ojasm07/Design-Control-and-Fabrication-of-Ornithopter/Major Project Review Presentation.pptx.pdf

30-June-22 | Department of Mechanical Engineering

# Design, Fabrication and Control of an Ornithopter

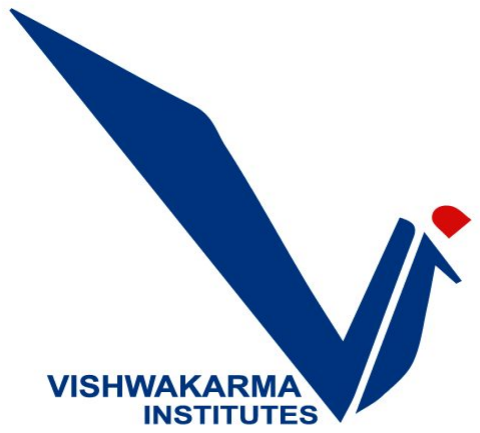
[picture p1: figure]

### Under the Guidance of : Prof. (Dr.) S. Pavitran

# Major Project

1

### Department of Mechanical Engineering

ME 4356

02-Jan-21 30-June-22 | Department of Mechanical Engineering | 2

## Group Members

Prof. (Dr.) Sunil Shinde, VIT-Mech, Pune, INDIA

Division & Roll No. | Name | Gr. No.
A-19 | Dhiren Bhabad | 11810572
C-22 | Ojas Mandlecha | 11810880
B-08 | Sankalp Gharmalkar | 11810519
A-68 | Shreeya Gadgil | 11810511

### Final Year Mechanical

30-June-22 | Department of Mechanical Engineering | 2

## Objectives

1. To build an efficient mechanism that can perform motion similar to the motion of wings of bird.
2. To design a mechanism for the tail of the ornithopter to control direction during flight.
3. Designing wings of the ornithopter considering the lift force required.
4. To design the robot in Solidworks software with consideration of assembly and manufacturing.
5. To build two testing setups to measure the thrust provided and to check the flight stability of the

ornithopter.

- Biomimetics or biomimicry is the emulation of the models, systems, and elements of nature for the purpose of solving complex human problems.
- In simple words “Biomimicry is the practice of looking to nature for inspiration to solve design problems in a regenerative way.”
- To replicate the wing flapping mechanism of Buzzard.
- The ornithopter could be used for surveillance, traffic monitoring or wildlife surveys.

## Introduction

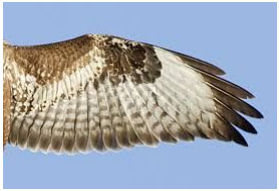
[picture p2: figure]

Fig.1. Wing of Buzzard

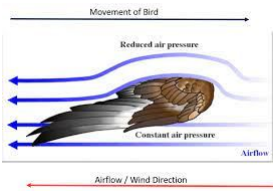
[picture p3: figure]
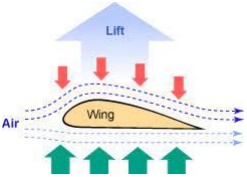
[picture p4: figure]

Fig.2. Flow of air over shape of wing

## Literature Review

Sr. No. | Title and Author | Objective | Methodology | Result and Conclusion
1. Design and Implementation of
an Ornithopter

Dan Sanderson, Jourdan
McKenna, Brian Baggaley,
Frederic Wight
1. The primary objective
is to make a
mechanical design.
2. Be able to transition
from flapping to
gliding and back to
flapping with minimal
disruption of flight
pattern.
1. The model was based on the Robin bird. Accordingly,
specifications were
calculated.
2. Different types of wing designs were tried and
tested.
3. Variation in flapping was tested on a setup with the ornithopter attached to a
zipline.
4. A Vernier Force Sensor was used to measure the force
during flapping.
1. The robot was able to transition from flipping to gliding with minimal flight pattern disruption.
2. Robot can achieve a velocity of 0.848 m/s on the zip line.
3. It was durable enough to withstand impacts while testing.

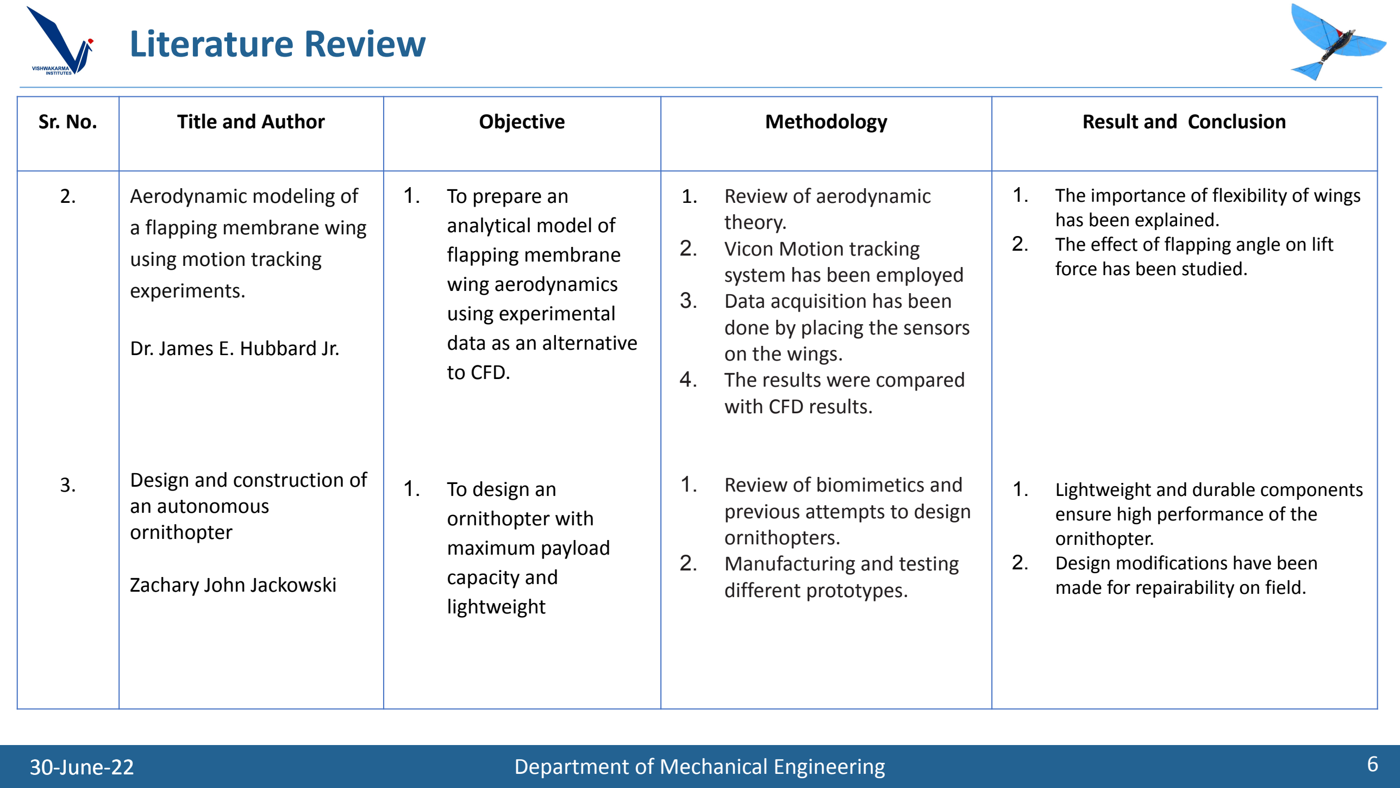
[picture p5: figure]
Literature Review; Aerodynamic modeling of; a flapping membrane wing; using motion tracking; experiments.; Dr. James E. Hubbard Jr.; Design and construction of an autonomous ornithopter; Zachary John Jackowski; 1. To prepare an analytical model of flapping membrane wing aerodynamics using experimental data as an alternative to CFD.; 1. To design an ornithopter with maximum payload capacity and lightweight; 1. Review of aerodynamic theory. 2. Vicon Motion tracking system has been employed 3. Data acquisition has been done by placing the sensors on the wings. 4. The results were compared with CFD results.; 1. Review of biomimetics and previous attempts to design ornithopters. 2. Manufacturing and testing different prototypes.; has been explained. 2. The effect of flapping angle on lift force has been studied.; 1. Lightweight and durable components ensure high performance of the ornithopter. 2. Design modifications have been made for repairability on field.

Sr. No. | Title and Author | Objective | Methodology | Result and Conclusion
1. The importance of flexibility of wings

## Methodology

Mechanism And
Calculation

Finding
mechanism for
respective task and
performing its
corresponding
calculations.

Design

CAD modeling of
the robot based on
the calculations.

Testing

Measurement of
acquired lift force
and flight stability
of prototypes.

Final Results and
Manufacturing

Finalizing the
Model.

Optimization

Optimization or
modification in
design according to
the results obtained
from testing.

## Determining the wing area

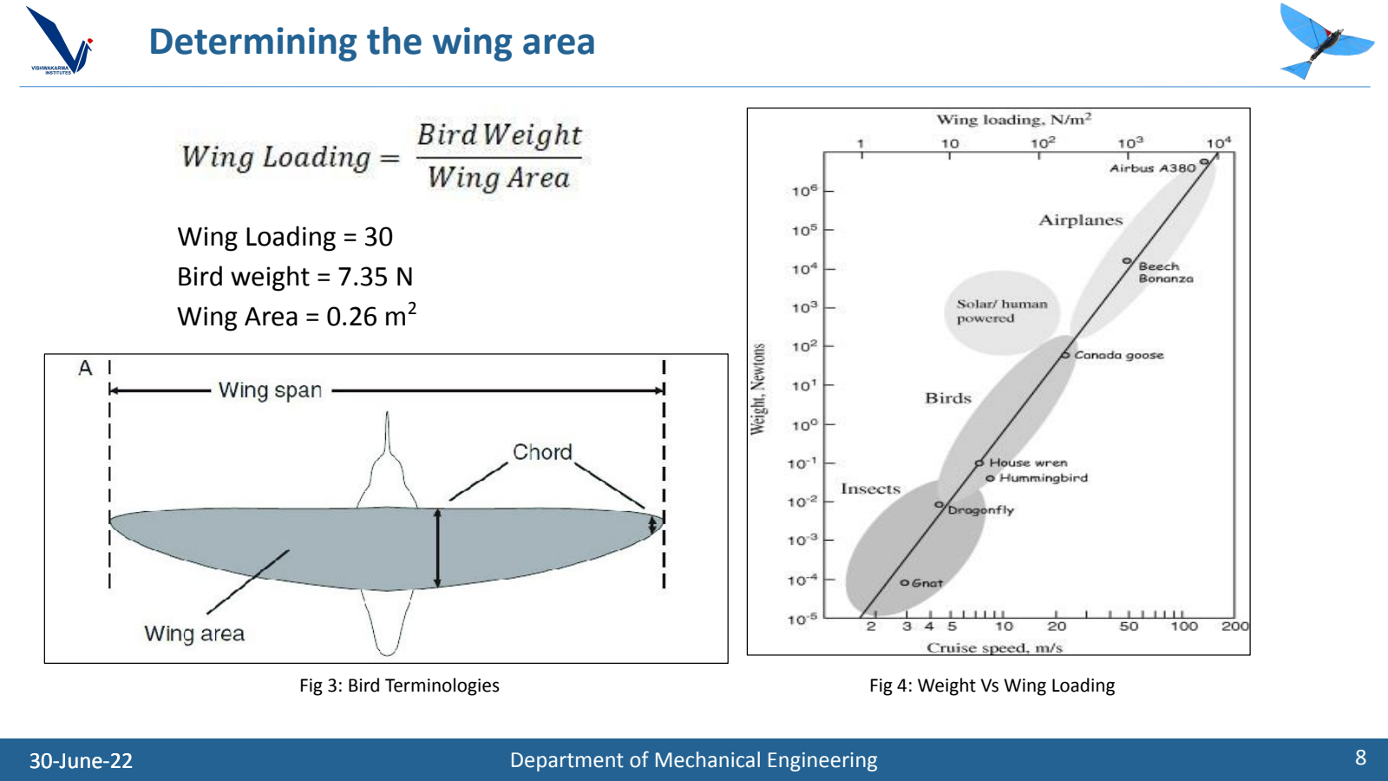
[picture p6: page 8]

Wing Loading = 30
Bird weight = 7.35 N
Wing Area = 0.26 m²
Fig 3: Bird Terminologies | Fig 4: Weight Vs Wing Loading

## Weight of Components

Department of Mechanical Engineering

Components | Weight (grams) | Quantities | Total Weight (grams)
Main Body | 75 | 1 | 75
Gear Box | 165 | - | 165
BLDC Motor | 80 | 1 | 80
Servo Motor | 45 | 1 | 45
Shaft & Bearings | 20 | 3 | 60
Electronics | 100 | - | 100
Battery | 85 | 1 | 85
Wings | 40 | 2 | 80
Total Weight | | | 690

Table No. 1 Weight Estimation

### - Down stroke - Lift force - Partial Thrust

### - Up stroke - Partial Thrust

## Wing Flexibility

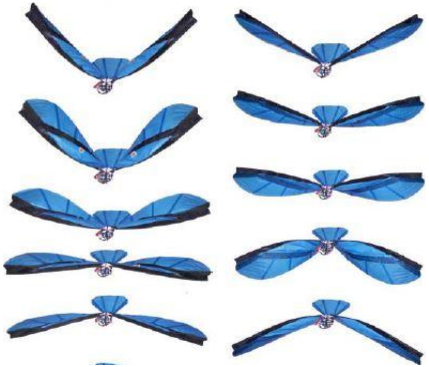
[picture p7: figure]

Fig 5: Wing positions of Ornithopter

## BLDC Motor Torque Calculations

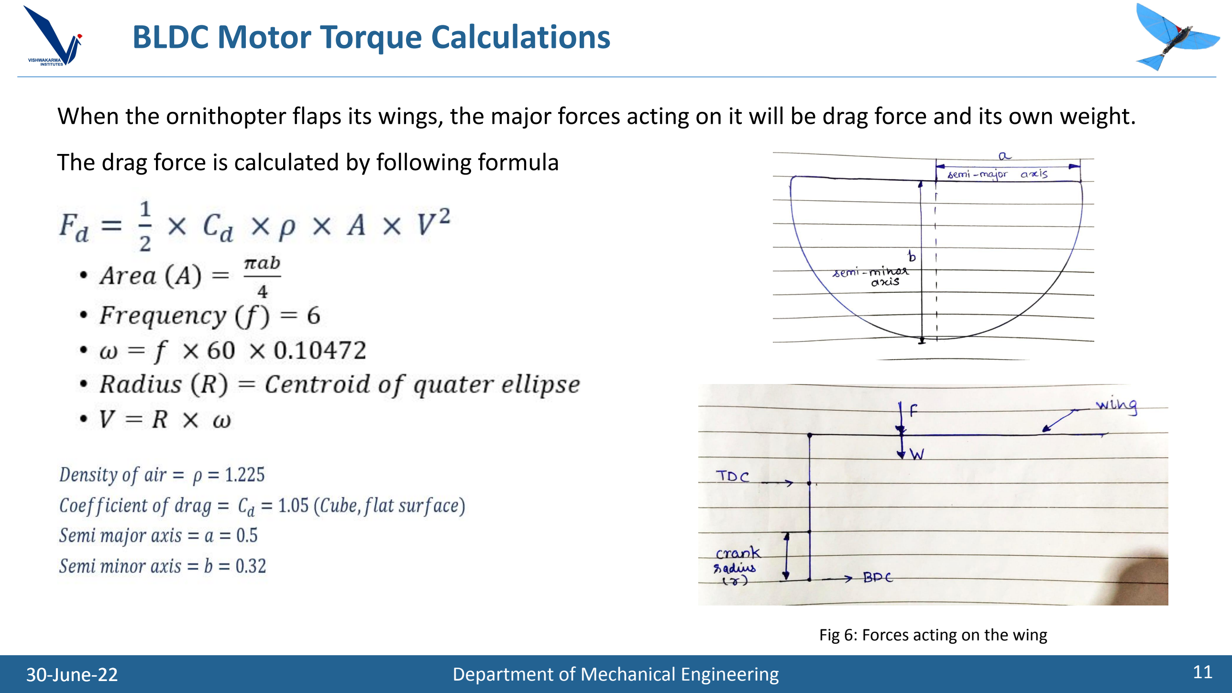
[picture p8: page 11]

When the ornithopter flaps its wings, the major forces acting on it will be drag force and its own weight.

The drag force is calculated by following formula

Fig 6: Forces acting on the wing

## BLDC Motor Torque Calculations

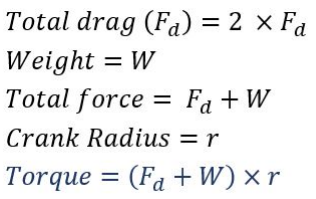
[picture p9: figure]

All these values and formulas were calculated in excel sheet to narrow down the the reduction ratio and

BLDC motor.

https://docs.google.com/spreadsheets/d/1AwN7oHJm2QgTFMpb154mPdjUXOrblMUWJqgVfvwyTiw/edit#

gid=0 (https://docs.google.com/spreadsheets/d/1AwN7oHJm2QgTFMpb154mPdjUXOrblMUWJqgVfvwyTiw/edit#gid=0)

## CAD model

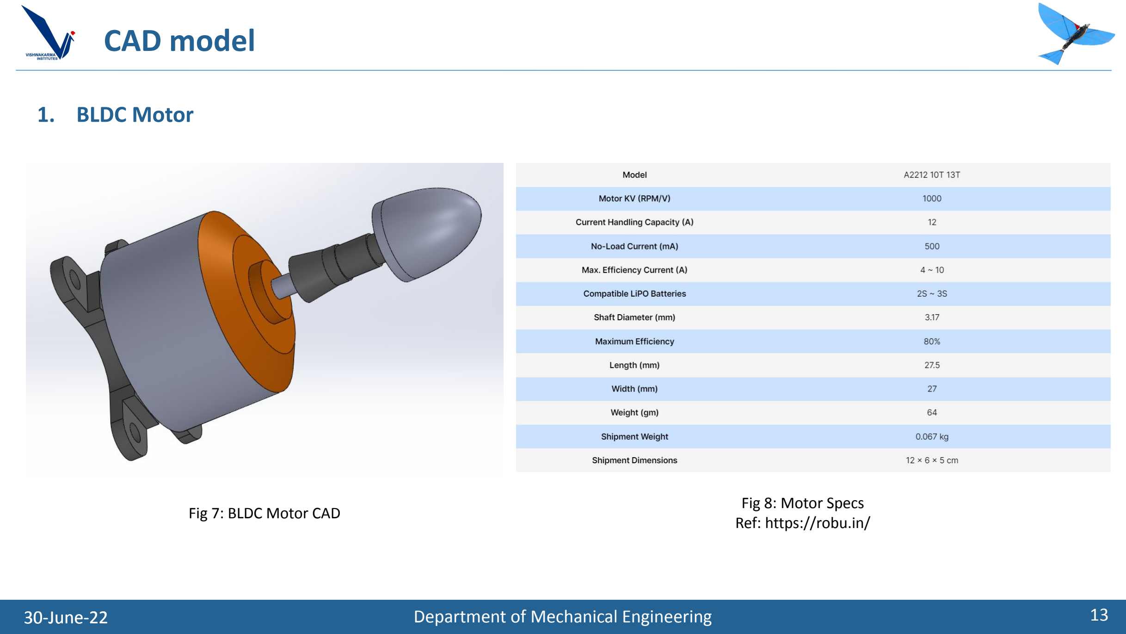
[picture p10: page 13]

Fig 8: Motor Specs
Ref: https://robu.in/ Fig 7: BLDC Motor CAD

### 1. BLDC Motor

## CAD model

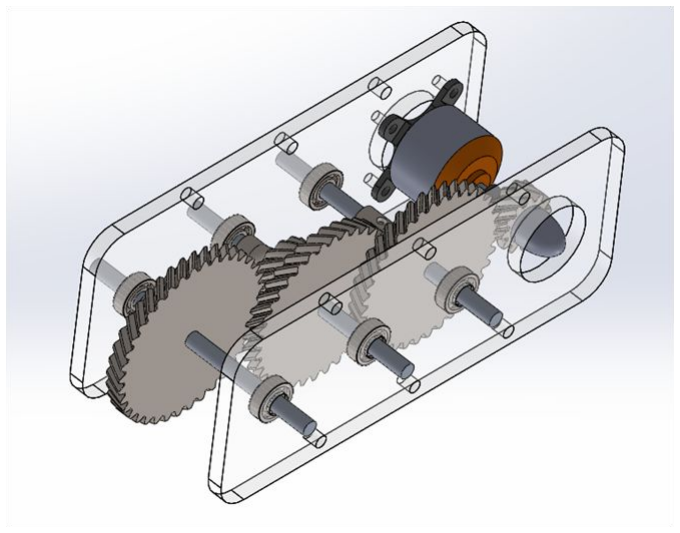
[picture p11: figure]

Fig 9: Gearbox with BLDC Motor

### 2. Gearbox

## Calculations

Gearbox Reduction Calculation

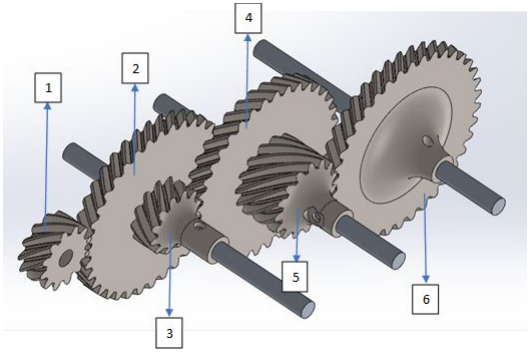
[picture p12: figure]

Gear No. | No. of teeth | Total Reduction achieved
1 (Input Gear) | 12 | 0
2 | 36 | 36/12=3
3 | 12 | 3 (Compound Gear)
4 | 36 | 3 x (36/12) = 9
5 | 15 | 9 (Compound Gear)
6 (Output Gear) | 38 | 9 x (38/15) = 22.8
Fig 10: Gearbox | | Table No. 2 Gear reduction values

Type of Gear Train: Compound Gear Train Type of gears used: Helical Gear

## CAD model

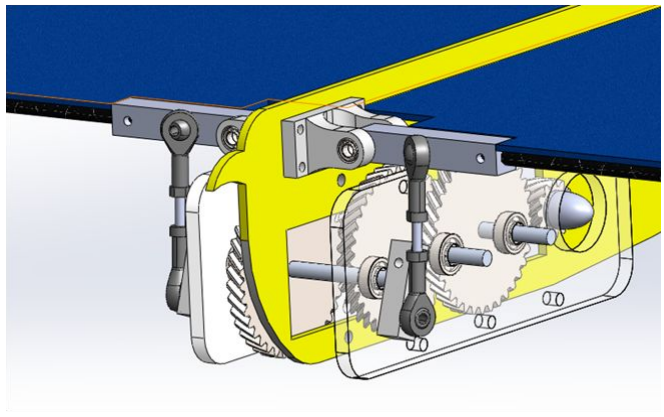
[picture p13: figure]

Fig 11: Wing Front Pivot

### 3. Ornithopter Wing Front Pivot Mechanism

- Assumption: We have assumed here, that when the crank is at the bottom dead center (lowest position) the wing would he horizontal.
- Considering this, geometrical relationship between the flapping angle of wing, crank radius, center distance between rod end bearings and distance between rod end bearing and frontal pivot was established.

AP = Center distance between rod end bearings (d)
BP = Crank Diameter (2r)
OA = Distance between rod end bearing and frontal pivot (x) ∠NOM = Flapping angle of wing (θ)

## Front pivot mechanism calculations

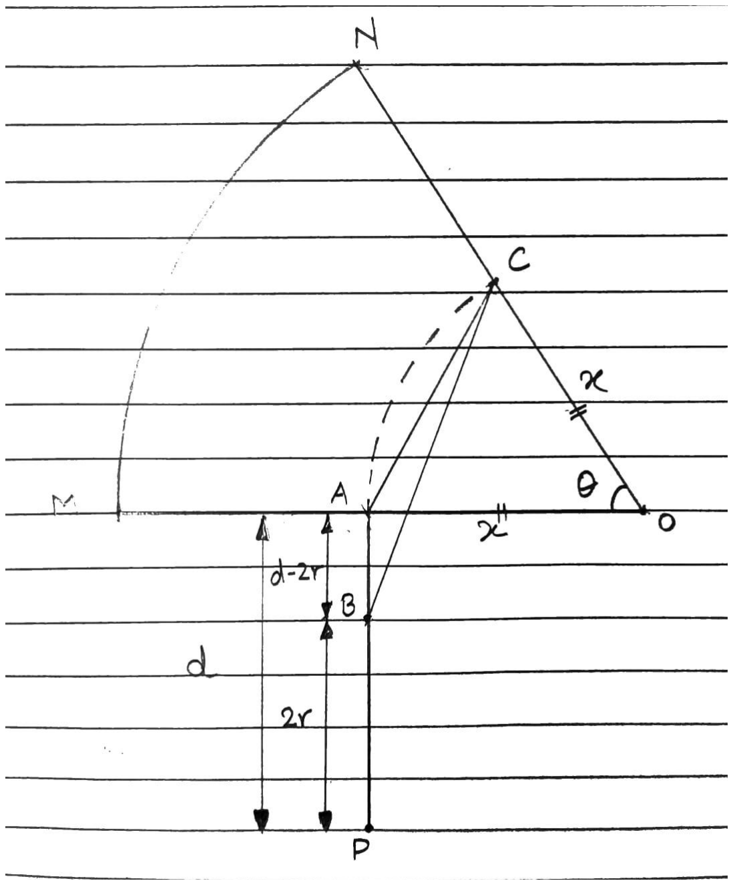
[picture p14: figure]

Fig.12: 2D representation of front pivot mechanism (front view)

## Front pivot mechanism calculations

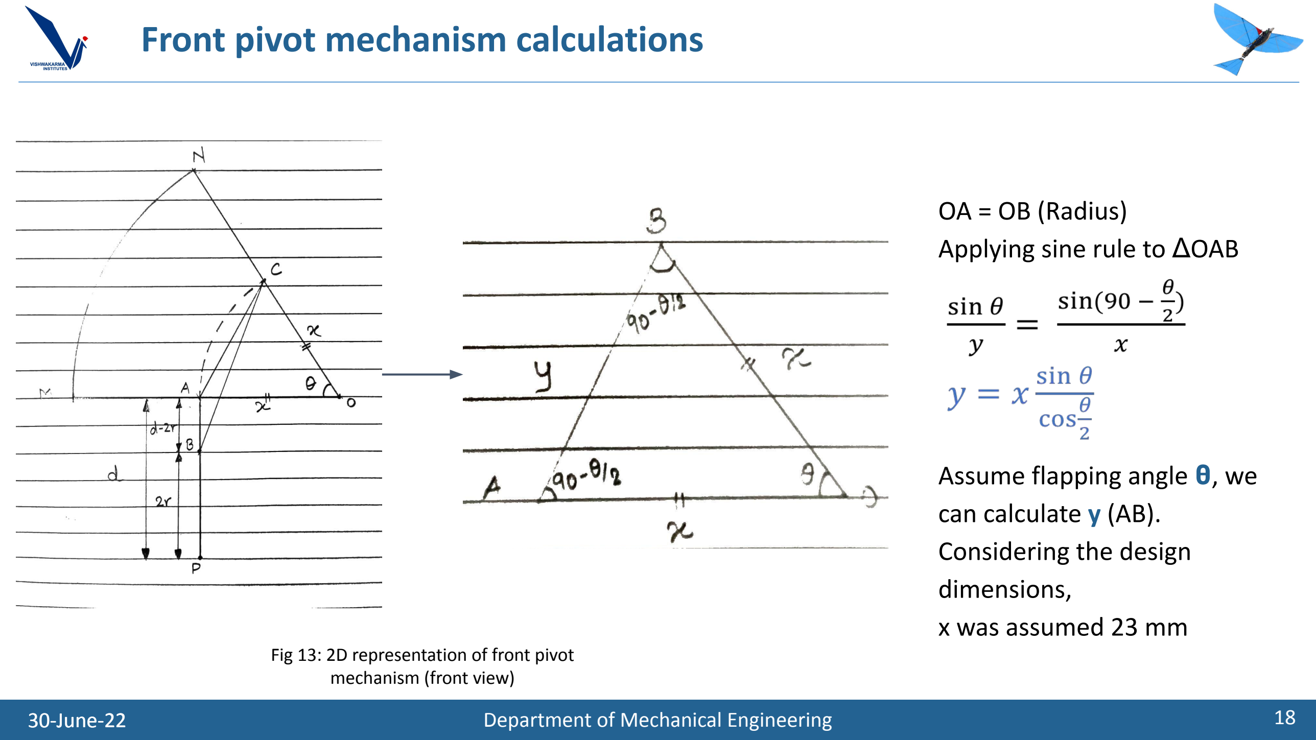
[picture p15: page 18]

OA = OB (Radius)
Applying sine rule to ΔOAB

Assume flapping angle ፀ, we can calculate y (AB).
Considering the design
dimensions,
x was assumed 23 mm

Fig 13: 2D representation of front pivot mechanism (front view)

## Front pivot mechanism calculations

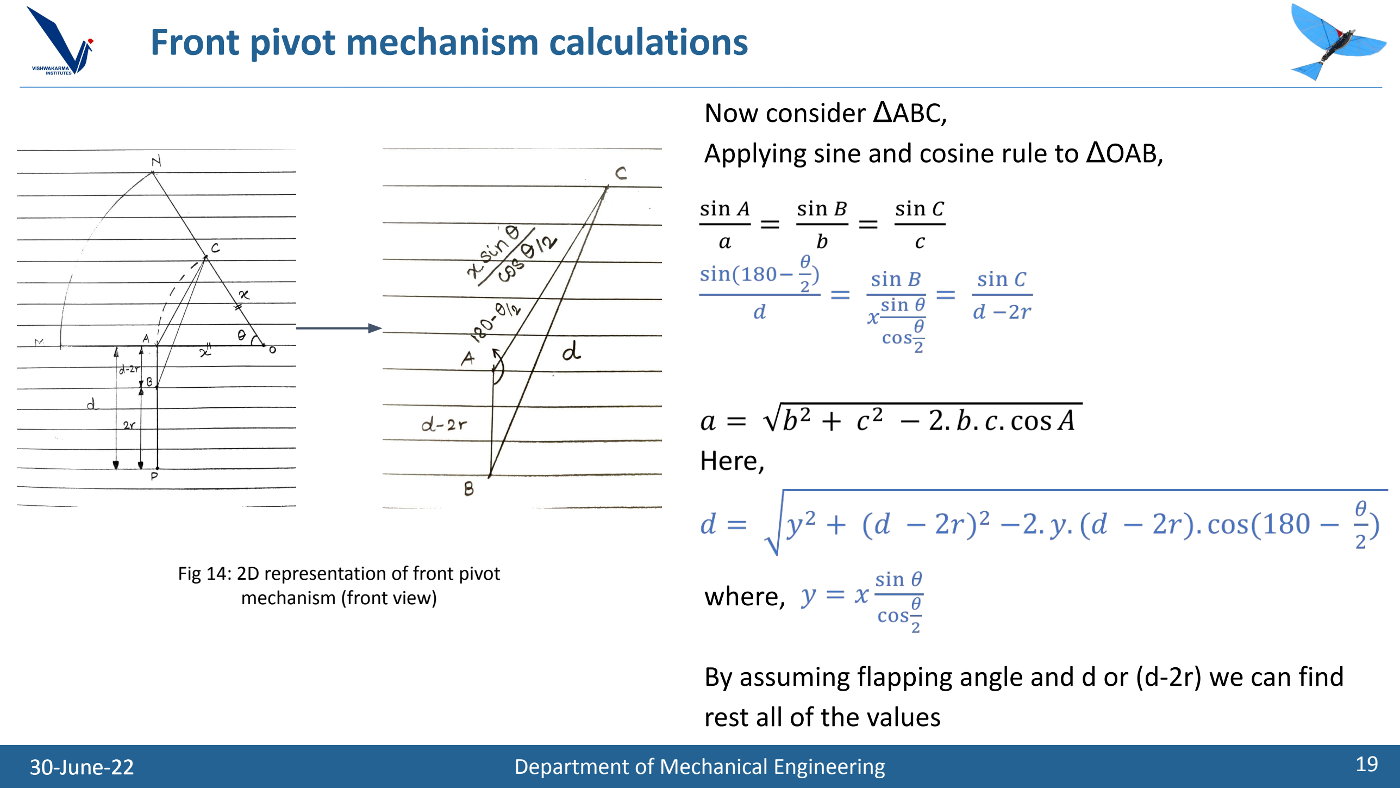
[picture p16: page 19]

Now consider ΔABC,
Applying sine and cosine rule to ΔOAB,

where,

By assuming flapping angle and d or (d-2r) we can find rest all of the values

Fig 14: 2D representation of front pivot mechanism (front view)

By using these formulas, these are assumed and obtained values,

Parameter | Value
θ | 60⁰
x | 23 mm
d | 51.5 mm
r | 11 mm

Table No. 3 Pivot geometric values

## Front pivot mechanism calculations

## CAD model

### 4. Ornithopter Wing Back Pivot Mechanism

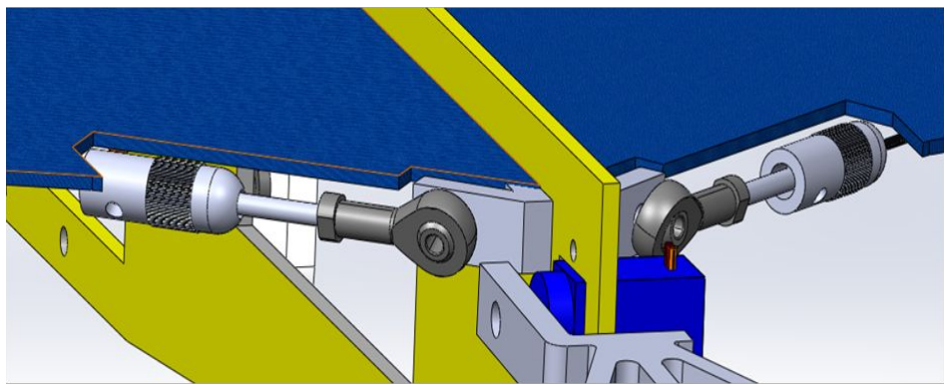
[picture p17: figure]

Fig 15: Wingback Pivot

## Servo Motor Torque Calculations

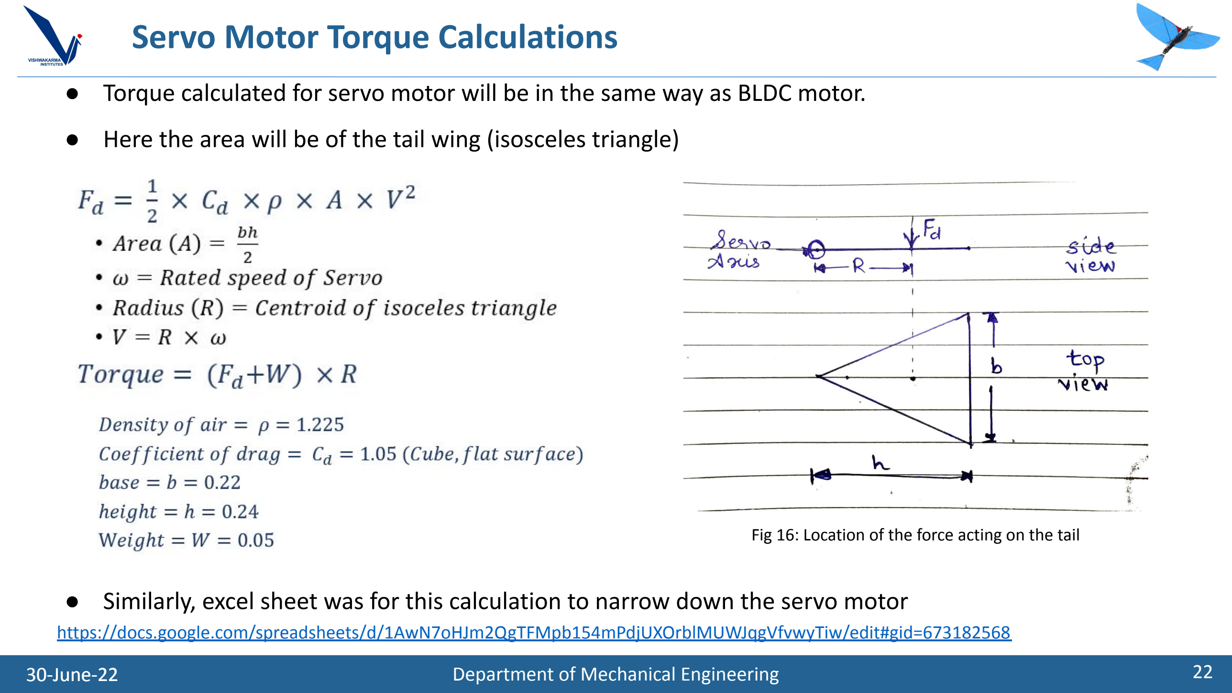
[picture p18: page 22]

- Torque calculated for servo motor will be in the same way as BLDC motor.
- Here the area will be of the tail wing (isosceles triangle)
- Similarly, excel sheet was for this calculation to narrow down the servo motor

https://docs.google.com/spreadsheets/d/1AwN7oHJm2QgTFMpb154mPdjUXOrblMUWJqgVfvwyTiw/edit#gid=673182568

Fig 16: Location of the force acting on the tail

## CAD model

### 5. Ornithopter Tail Mechanism

- Servo motor SG90 has been used because of ease of position control

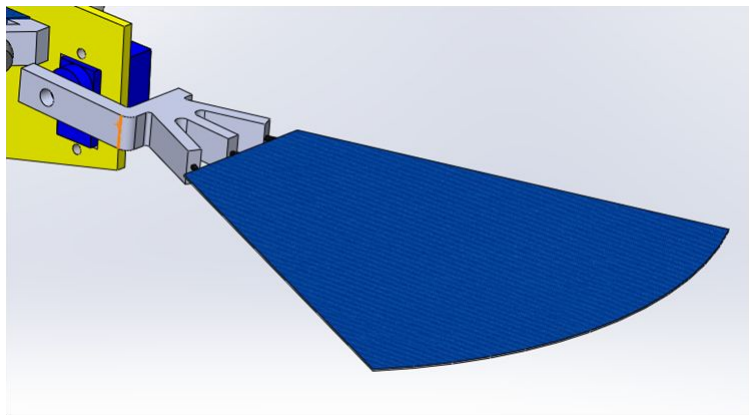
[picture p19: figure]

Fig.17. Tail mechanism

## CAD model

### 5. Final CAD

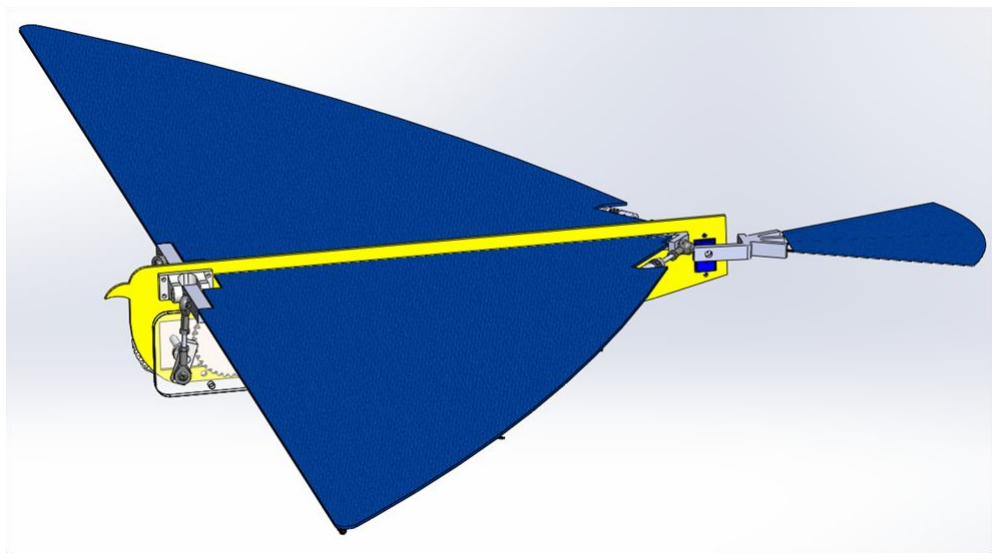
[picture p20: figure]

Fig.18: Final CAD

# Analysis(1/4 ):Bearing Housing

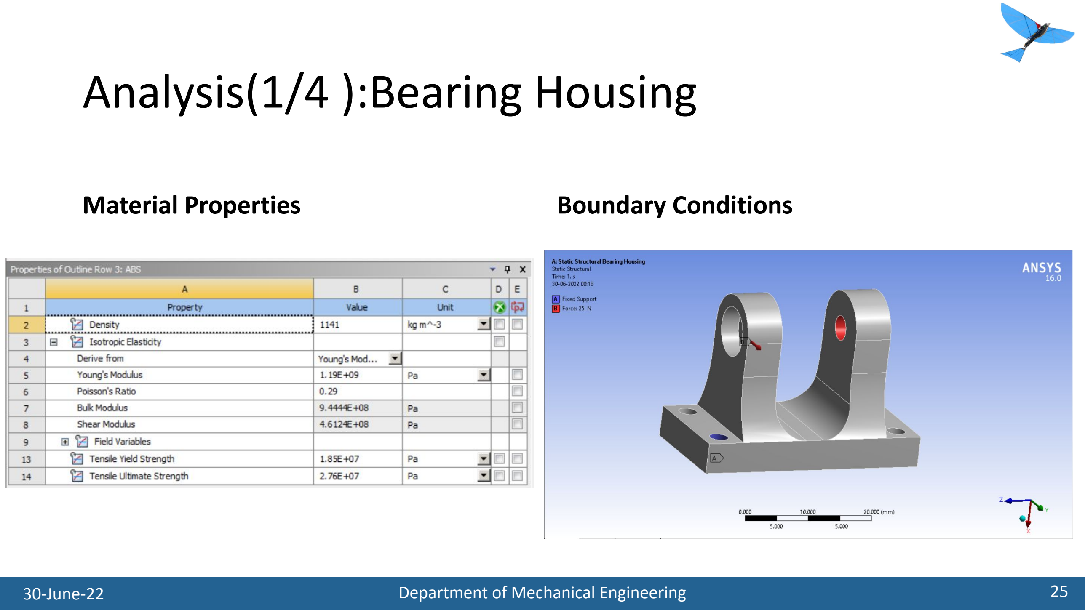
[picture p21: page 25]

30-June-22 | Department of Mechanical Engineering
Material Properties | Boundary Conditions

25

# Analysis(1/4 ):Bearing Housing

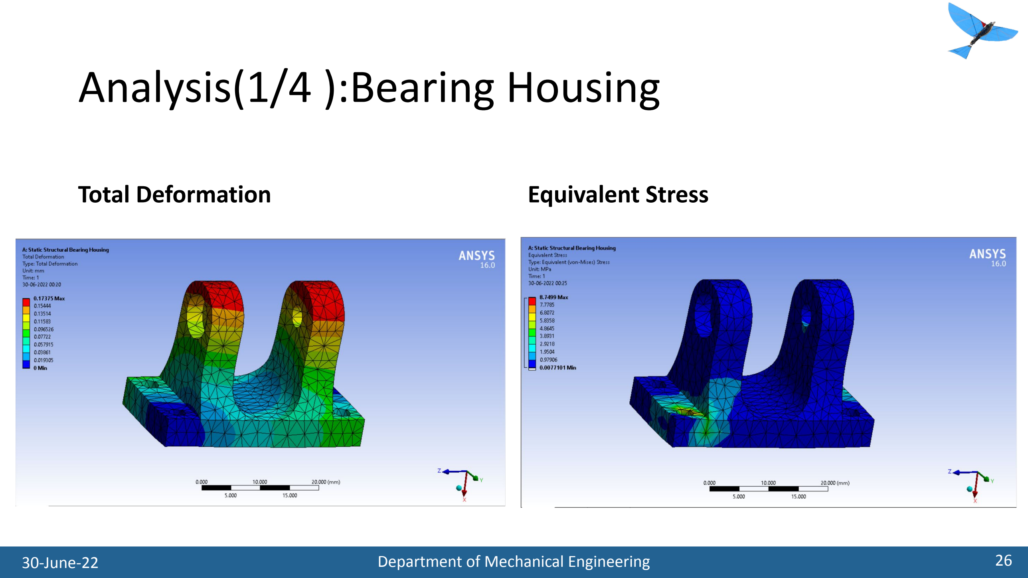
[picture p22: page 26]

30-June-22 | Department of Mechanical Engineering
Total Deformation | Equivalent Stress

26

# Analysis(2/4 ):Rod Connecting link

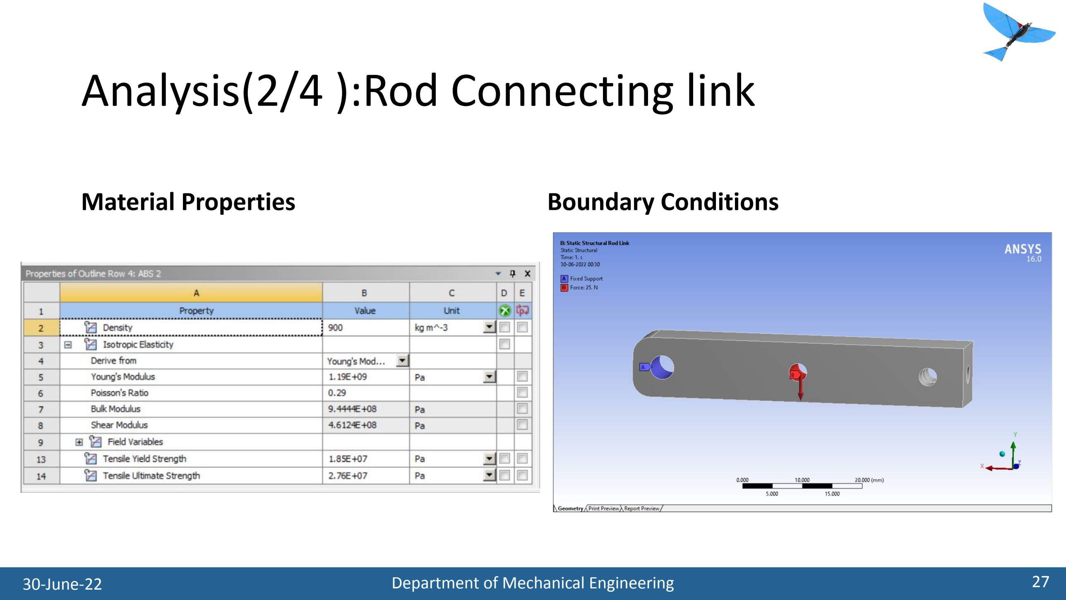
[picture p23: page 27]

30-June-22 | Department of Mechanical Engineering
Material Properties | Boundary Conditions

27

# Analysis(2/4): Rod Connecting Link

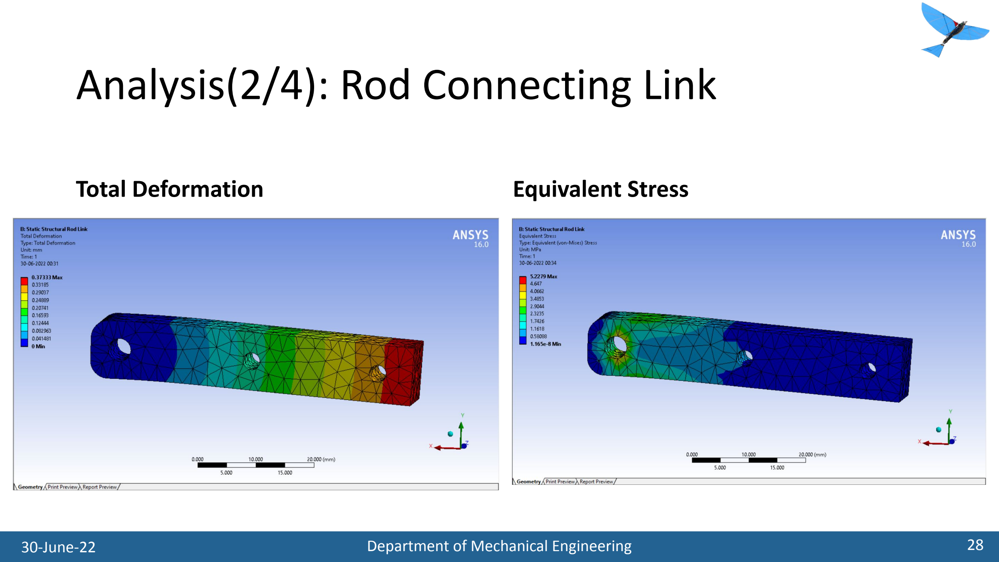
[picture p24: page 28]

30-June-22 | Department of Mechanical Engineering
Total Deformation | Equivalent Stress

28

# Analysis(3/4): Crank

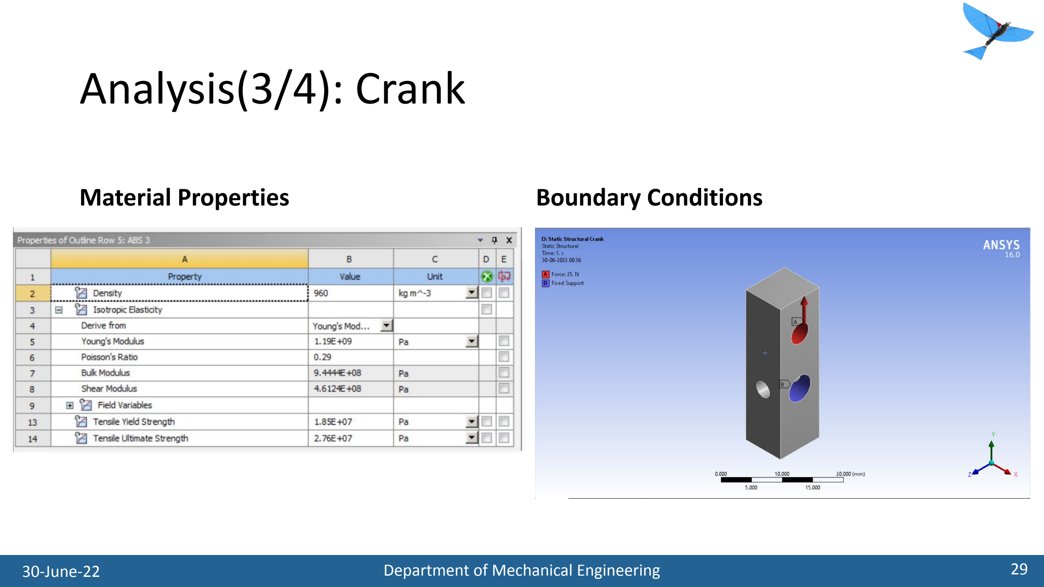
[picture p25: page 29]

30-June-22 | Department of Mechanical Engineering
Material Properties | Boundary Conditions

29

# Analysis(3/4): Crank

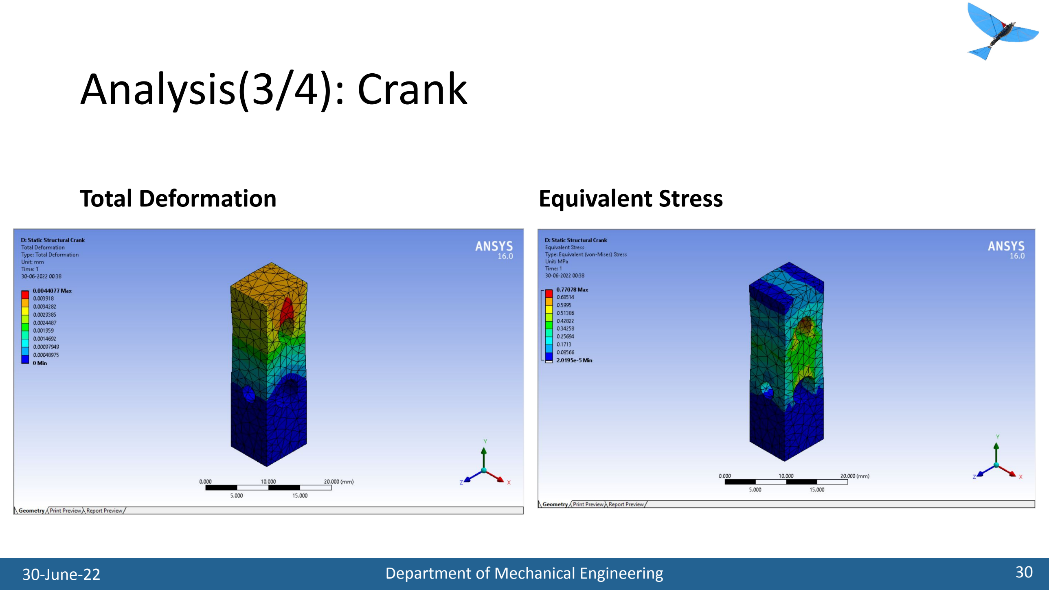
[picture p26: page 30]

30-June-22 | Department of Mechanical Engineering
Total Deformation | Equivalent Stress

30

# Analysis(4/4): Rod

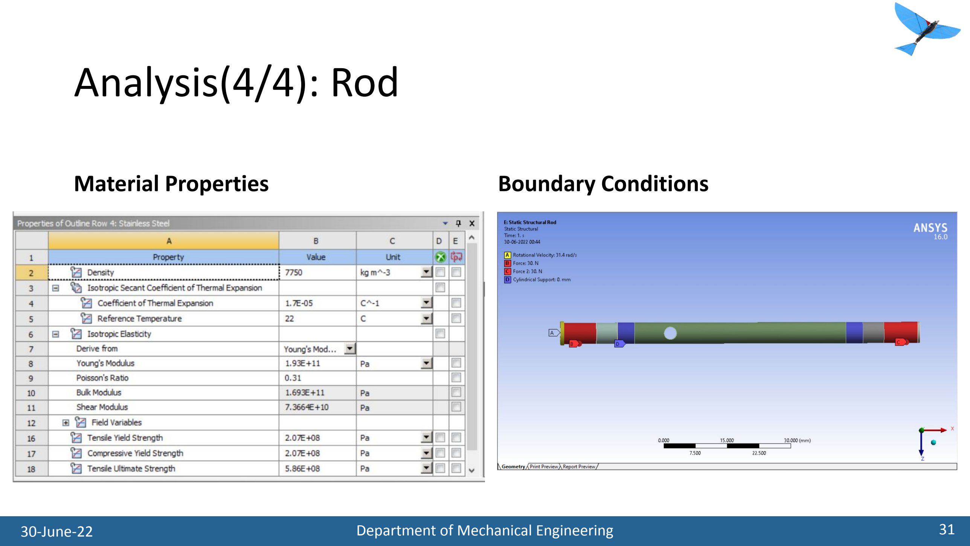
[picture p27: page 31]

30-June-22 | Department of Mechanical Engineering
Material Properties | Boundary Conditions

31

# Analysis(4/4): Rod

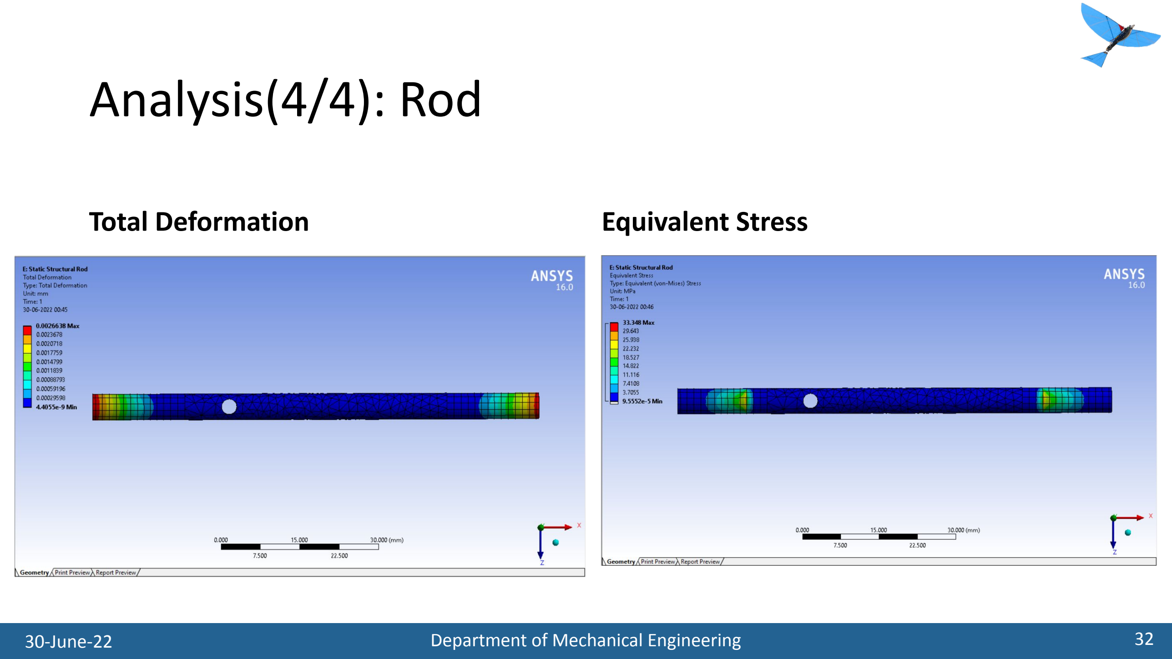
[picture p28: page 32]

30-June-22 | Department of Mechanical Engineering
Total Deformation | Equivalent Stress

32

## Materials & manufacturing processes

- It was essential to have the weight of the ornithopter as minimum as possible.
- Gears are 3d printed of ABS material.
- The main body is made up of fiberglass and is cut to required profile by waterjet cutting.
- The skeleton of the wings is made up of carbon fiber rods
- The wings have been made up of nylon fiber.

## Electronics

### Components

- Electronic Speed Controller
- Radio frequency modules (2.4 GHz)
- Arduino UNO
- Joystick module

## Electronic Circuit

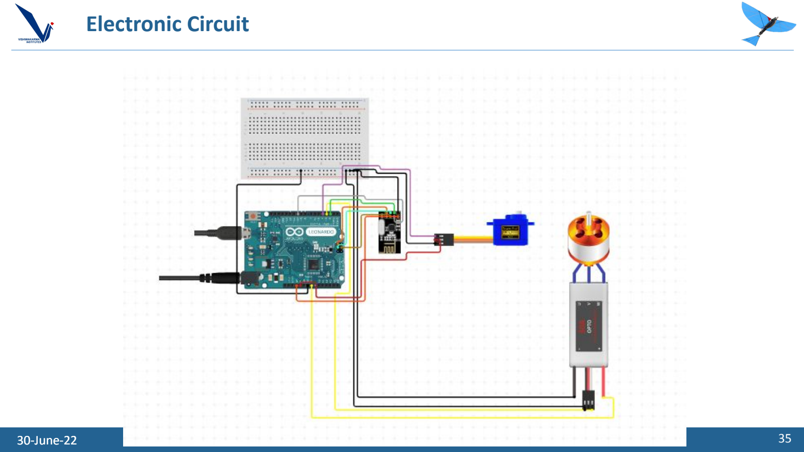
[picture p29: page 35]

## Electronic circuit for the Controller

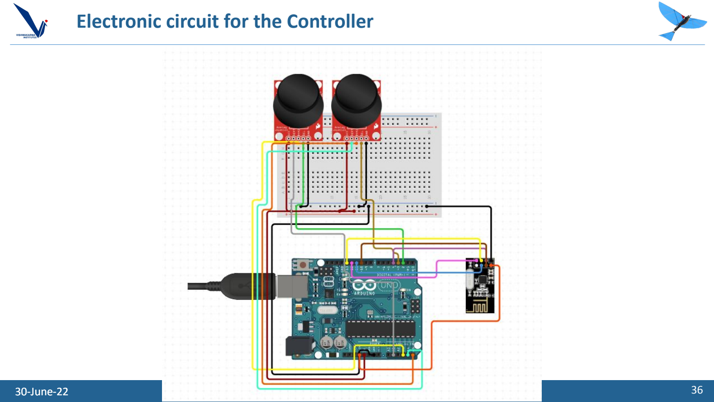
[picture p30: page 36]

## Electronics

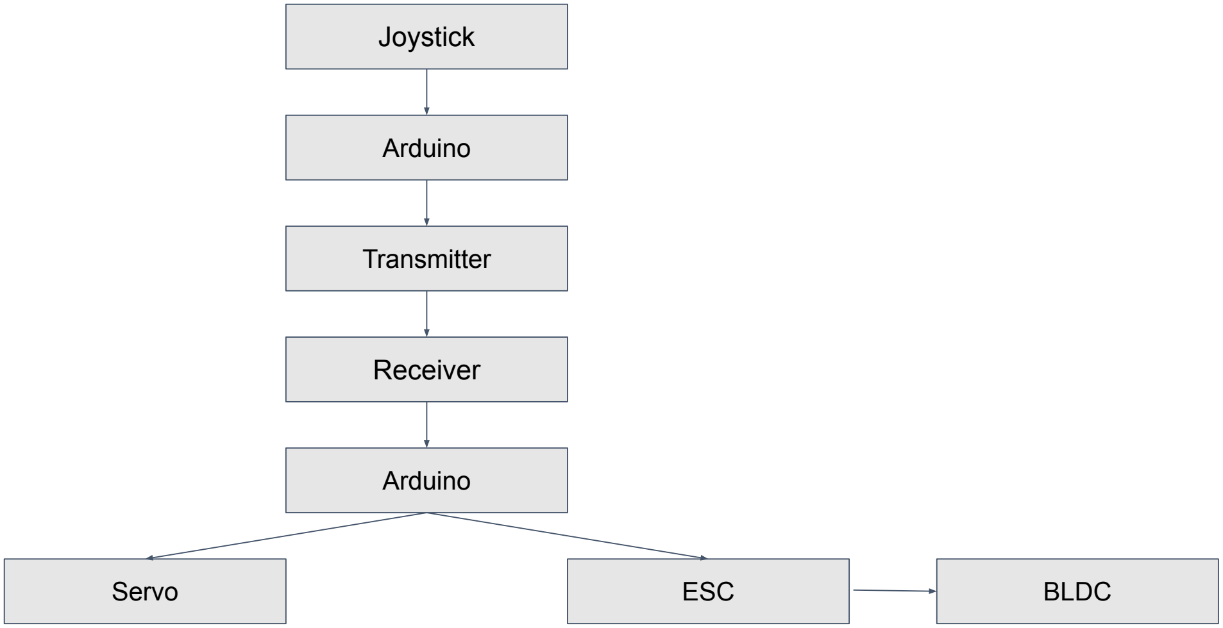
[picture p31: figure]
Joystick; Arduino; Transmitter; Receiver; Servo; ESC; BLDC

## Test Setup

- Based on the principle of balancing of moments

FLift * r = Fd * r

Lift | downward force

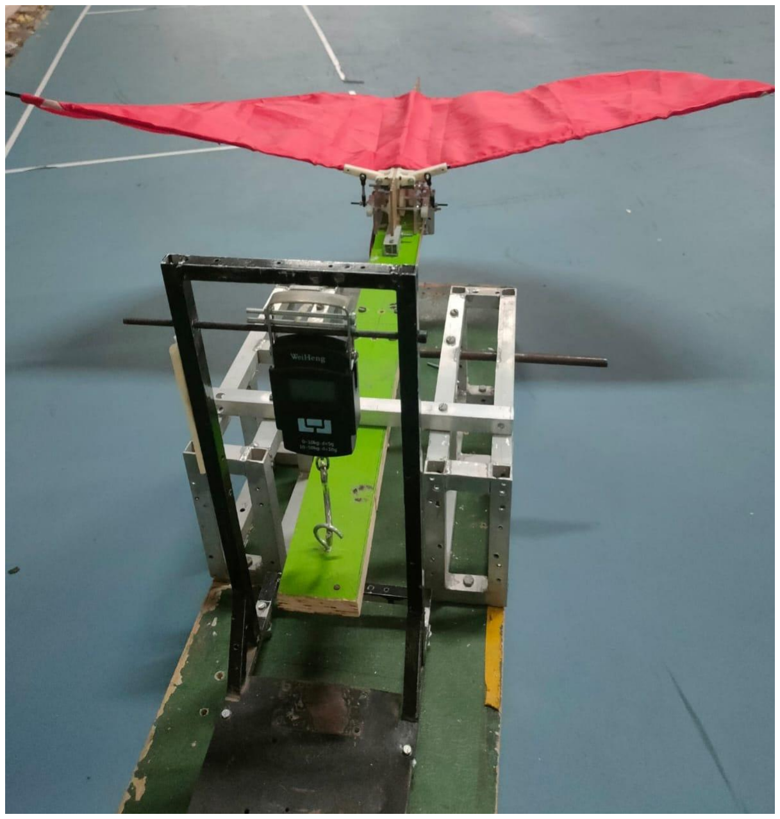
[picture p32: figure]

Fig.19. Test setup for lift measurement

Fig 18: Moment balance on the test setup

## Test Setup

- The ornithopter was suspended from a rope and actuated
- A slack has been observed in rope which indicated generation of lift force
- The ornithopter also followed a circular path indicating that it has a forward thrust.

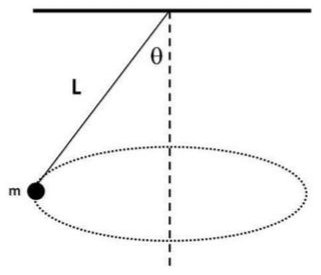
[picture p33: figure]

Fig 20: Representation of the test setup

## Challenges

- Finding the required materials and components.
- Most of the manufacturing processes employed were time consuming which increased the project

duration

- 3d printed spur gears weared out quickly which were later replaced by helical gears.
- It is a dynamic system hence it was difficult to do the calculations and the analysis.
- It was difficult to troubleshoot the problems related to electronics components.
- In the first test setup, the weight measuring device was unable to measure the dynamic readings.

## Conclusion

- A suitable wing flapping mechanism has been chosen to mimic the flapping action of birds.
- The wing area has been calculated based on the approximate weight and the concept of wing loading.
- Suitable BLDC motor and gear ratio value has been selected based on the force required for flapping

and the flapping frequency

- The ornithopter has been designed based on these inputs. Structural analysis of required parts has

been carried out.

- Two test setups have been designed to verify the lift force and the forward thrust achieved by the

ornithopter.

- The ornithopter has been wirelessly controlled with the help of radio frequency module.

# Thank You!
