ojasm07/Design-Control-and-Fabrication-of-Ornithopter/rf_receiver_1.ino

#include <SPI.h>
#include <nRF24L01.h>
#include <RF24.h>

RF24 radio(7, 8); // CE, CSN

const byte address[6] = "00004";

void setup() {
  Serial.begin(9600);
  radio.begin();
  radio.openReadingPipe(0, address);
  radio.setPALevel(RF24_PA_MIN);
  radio.startListening();
}

void loop() {
  
  if (radio.available()) {
    char text[] = "op";
    radio.read(&text, sizeof(text));
    Serial.println(text);
  }
 
}
